matthewlai/GloveElectronics/Glove.pdf

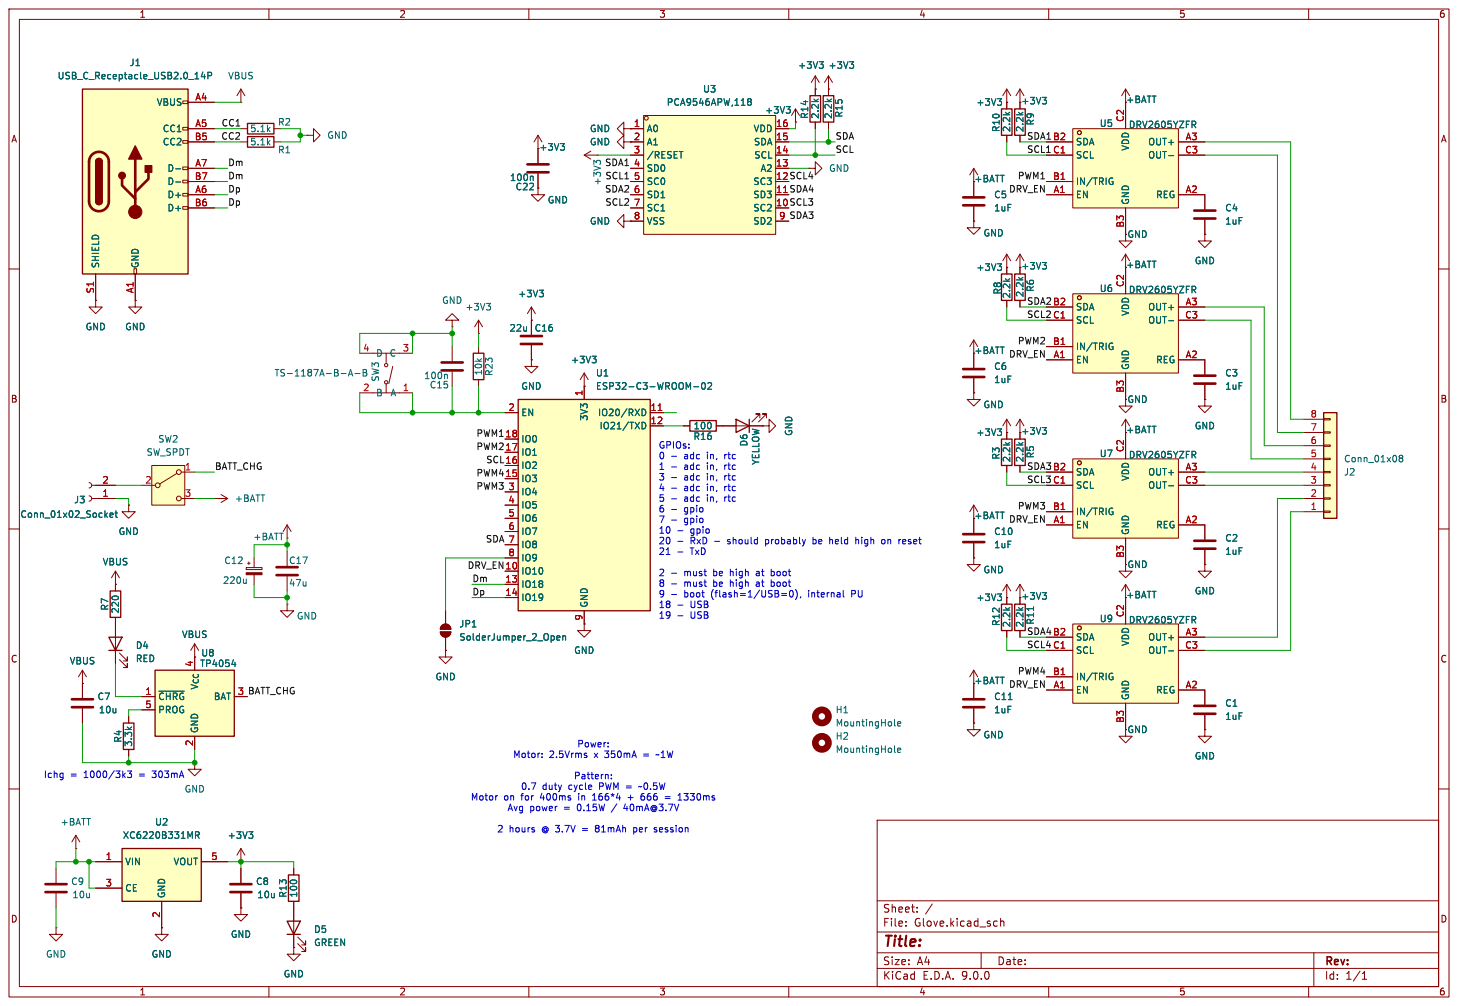
[picture p1: page 1]

Id: 1/1 Title: File: Glove.kicad_sch Sheet: / +3V3 A

Pattern: 0.7 duty cycle PWM = ~0.5W

Motor on for 400ms in 166*4 + 666 = 1330ms Avg power = 0.15W / 40mA@3.7V
