matthewlai/GloveElectronics/MotorConnectorBoard/MotorConnectorBoard.kicad_pcb

## KiCad design MotorConnectorBoard/MotorConnectorBoard.kicad_pcb (2026-07-17)

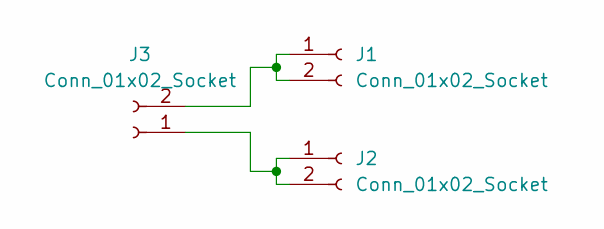
[picture p2: schematic MotorConnectorBoard.kicad_sch]

Parts:
J1, J2: Conn_01x02_Socket; PinHeader_1x02_P2.54mm_Vertical
J3: Conn_01x02_Socket; VLV101040A

Connections:
unnamed: J1.1, J1.2, J3.2
unnamed: J2.1, J2.2, J3.1

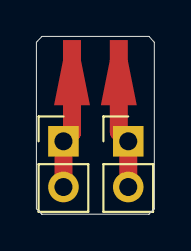
[picture p3: board MotorConnectorBoard.kicad_pcb from above]

Board: 2 copper layers, 6.6 x 9.9 mm, 3 parts (0 on the bottom side), 2 nets.
