matthewlai/GloveElectronics/Glove.kicad_pcb

## KiCad design Glove.kicad_pcb (2026-07-17)

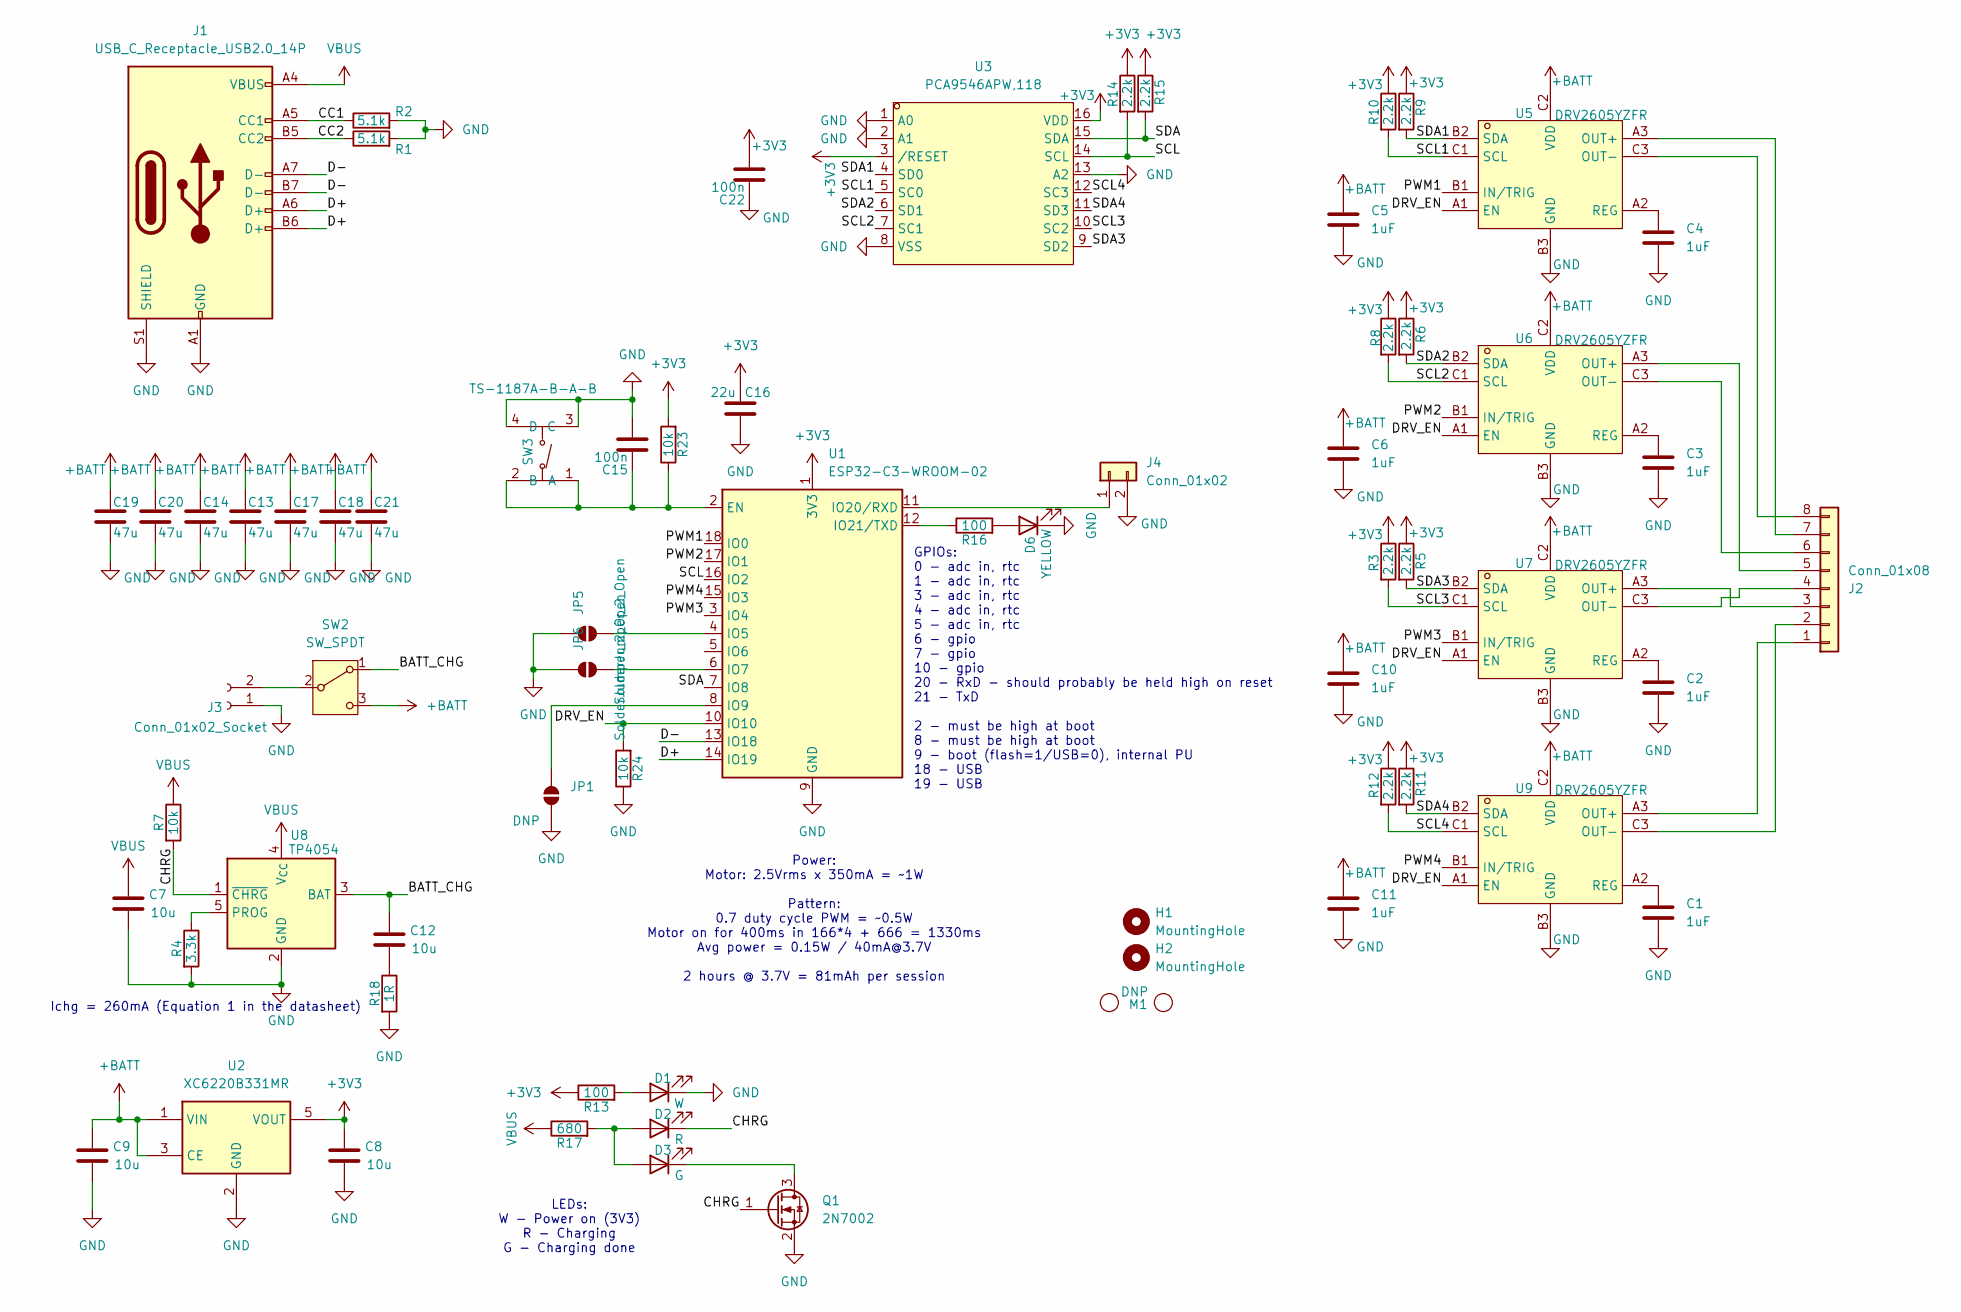
[picture p4: schematic Glove.kicad_sch]

Parts:
C1, C2, C3, C4, C5, C6, C10, C11: 1uF; C_0402_1005Metric; LCSC C52923
C7, C8, C9, C12: 10u; C_0603_1608Metric; LCSC C19702
C13, C14, C17, C18, C19, C20, C21: 47u; C_1206_3216Metric; LCSC C96123
C15, C22: 100n; C_0402_1005Metric; LCSC C1525
C16: 22u; C_0603_1608Metric; LCSC C59461
D1: W; LED_0603_1608Metric; LCSC C2290
D2: R; LED_0603_1608Metric; LCSC C2286
D3: G; LED_0603_1608Metric; LCSC C12624
D6: YELLOW; LED_0805_2012Metric; LCSC C2296
H1, H2: MountingHole; MountingHole_2.2mm_M2
J1: USB_C_Receptacle_USB2.0_14P; USB-C_SMD-TYPE-C-31-M-12; LCSC C165948
J2: Conn_01x08; PinHeader_2x04_P2.54mm_Vertical; LCSC C32713277
J3: Conn_01x02_Socket; CONN-SMD_B2B-PH-SM4-TB-LF-SN; LCSC C265003
J4: Conn_01x02; PinHeader_1x02_P2.54mm_Vertical
JP1: DNP; PinHeader_1x02_P2.54mm_Vertical
JP5, JP6: SolderJumper_2_Open; SolderJumper-2_P1.3mm_Open_RoundedPad1.0x1.5mm
M1: DNP; VLP2
Q1: 2N7002; SOT-323_SC-70; LCSC C7420322
R1, R2: 5.1k; R_0402_1005Metric; LCSC C25905
R3, R5, R6, R8, R9, R10, R11, R12, R14, R15: 2.2k; R_0402_1005Metric; LCSC C25879
R4: 3.3k; R_0402_1005Metric; LCSC C25890
R7, R23, R24: 10k; R_0402_1005Metric; LCSC C25744
R13, R16: 100; R_0402_1005Metric; LCSC C25076
R17: 680; R_0402_1005Metric; LCSC C25130
R18: 1R; R_0402_1005Metric; LCSC C25086
SW2: SW_SPDT; SW-TH_SK12D07VG3; LCSC C431547
SW3: TS-1187A-B-A-B; SW-SMD_4P-L5.1-W5.1-P3.70-LS6.5-TL_H1.5; LCSC Part C318884
U1: ESP32-C3-WROOM-02; LCSC C2934560
U2: XC6220B331MR; SOT-23-5; LCSC C86534
U3: PCA9546APW,118; SOP-16_L5.0-W4.4-P0.65-LS6.4-BL; LCSC Part C149507
U5, U6, U7, U9: DRV2605YZFR; DSBGA-9_L1.5-W1.5-R3-C3-P0.50-BL; LCSC Part C81079
U8: TP4054; SOT-23-5; LCSC C32574

Connections:
+3V3: C8.1, C16.1, C22.2, R3.1, R5.1, R6.1, R8.1, R9.1, R10.1, R11.1, R12.1, R13.1, R14.1, R15.1, R23.2, U1.1 (3V3), U2.5 (VOUT), U3.3 (/RESET), U3.16 (VDD)
+BATT: C5.1, C6.1, C9.1, C10.1, C11.1, C13.1, C14.1, C17.1, C18.1, C19.1, C20.1, C21.1, SW2.3 (C), U2.1 (VIN), U2.3 (CE), U5.C2 (VDD), U6.C2 (VDD), U7.C2 (VDD), U9.C2 (VDD)
/BATT_CHG: C12.1, SW2.1 (A), U8.3 (BAT)
/CC1: J1.A5 (CC1), R2.1
/CC2: J1.B5 (CC2), R1.1
/CHRG: D2.1 (K), Q1.1 (G), R7.2, U8.1 (~CHRG)
/D+: J1.A6 (D+), J1.B6 (D+), U1.14 (IO19)
/D-: J1.A7 (D-), J1.B7 (D-), U1.13 (IO18)
/DRV_EN: R24.2, U1.10 (IO10), U5.A1 (EN), U6.A1 (EN), U7.A1 (EN), U9.A1 (EN)
/PWM1: U1.18 (IO0), U5.B1 (IN/TRIG)
/PWM2: U1.17 (IO1), U6.B1 (IN/TRIG)
/PWM3: U1.3 (IO4), U7.B1 (IN/TRIG)
/PWM4: U1.15 (IO3), U9.B1 (IN/TRIG)
/SCL: R14.2, U1.16 (IO2), U3.14 (SCL)
/SCL1: R10.2, U3.5 (SC0), U5.C1 (SCL)
/SCL2: R8.2, U3.7 (SC1), U6.C1 (SCL)
/SCL3: R3.2, U3.10 (SC2), U7.C1 (SCL)
/SCL4: R12.2, U3.12 (SC3), U9.C1 (SCL)
/SDA: R15.2, U1.7 (IO8), U3.15 (SDA)
/SDA1: R9.2, U3.4 (SD0), U5.B2 (SDA)
/SDA2: R6.2, U3.6 (SD1), U6.B2 (SDA)
/SDA3: R5.2, U3.9 (SD2), U7.B2 (SDA)
/SDA4: R11.2, U3.11 (SD3), U9.B2 (SDA)
GND: C1.2, C2.2, C3.2, C4.2, C5.2, C6.2, C7.2, C8.2, C9.2, C10.2, C11.2, C13.2, C14.2, C15.2, C16.2, C17.2, C18.2, C19.2, C20.2, C21.2, C22.1, D1.1 (K), D6.1 (K), J1.A1 (GND), J1.A12 (GND), J1.B1 (GND), J1.B12 (GND), J1.S1 (SHIELD), J3.1, J4.2, JP1.1 (A), JP5.2 (B), JP6.2 (B), Q1.2 (S), R1.2, R2.2, R4.2, R18.2, R24.1, SW3.3 (C), SW3.4 (D), U1.9 (GND), U1.19 (GND), U2.2 (GND), U3.1 (A0), U3.2 (A1), U3.8 (VSS), U3.13 (A2), U5.B3 (GND), U6.B3 (GND), U7.B3 (GND), U8.2 (GND), U9.B3 (GND)
unnamed: C12.2, R18.1
unnamed: D1.2 (A), R13.2
unnamed: D2.2 (A), D3.2 (A), R17.2
unnamed: D3.1 (K), Q1.3 (D)
unnamed: D6.2 (A), R16.2
unnamed: J2.1, U9.A3 (OUT+)
unnamed: J2.2, U9.C3 (OUT-)
unnamed: J2.3, U7.A3 (OUT+)
unnamed: J2.4, U7.C3 (OUT-)
unnamed: J2.5, U6.A3 (OUT+)
unnamed: J2.6, U6.C3 (OUT-)
unnamed: J2.7, U5.A3 (OUT+)
unnamed: J2.8, U5.C3 (OUT-)
unnamed: J3.2, SW2.2 (B)
unnamed: J4.1, U1.11 (IO20/RXD)
unnamed: JP1.2 (B), U1.8 (IO9)
unnamed: JP5.1 (A), U1.4 (IO5)
unnamed: JP6.1 (A), U1.6 (IO7)
unnamed: C15.1, R23.1, SW3.1 (A), SW3.2 (B), U1.2 (EN)
unnamed: R16.1, U1.12 (IO21/TXD)
unnamed: C4.1, U5.A2 (REG)
unnamed: C3.1, U6.A2 (REG)
unnamed: C2.1, U7.A2 (REG)
unnamed: R4.1, U8.5 (PROG)
unnamed: C1.1, U9.A2 (REG)
VBUS: C7.1, J1.A4 (VBUS), J1.A9 (VBUS), J1.B4 (VBUS), J1.B9 (VBUS), R7.1, R17.1, U8.4 (V_{CC})

Notes on the sheet:
LEDs: W - Power on (3V3) R - Charging G - Charging done
GPIOs: 0 - adc in, rtc 1 - adc in, rtc 3 - adc in, rtc 4 - adc in, rtc 5 - adc in, rtc 6 - gpio 7 - gpio 10 - gpio 20 - RxD - should probably be held high on reset 21 - TxD 2 - must be high at boot 8 - must be high at boot 9 - boot (flash=1/USB=0), internal PU 18 - USB 19 - USB
Power: Motor: 2.5Vrms x 350mA = ~1W Pattern: 0.7 duty cycle PWM = ~0.5W Motor on for 400ms in 166*4 + 666 = 1330ms Avg power = 0.15W / 40mA@3.7V 2 hours @ 3.7V = 81mAh per session
Ichg = 260mA (Equation 1 in the datasheet)

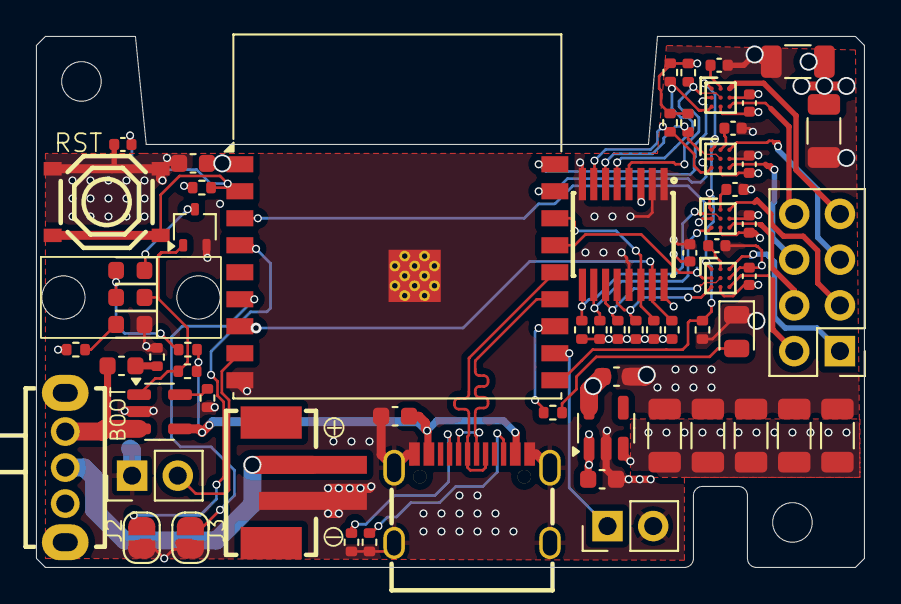
[picture p5: board Glove.kicad_pcb from above]

Board: 4 copper layers, 46.0 x 29.5 mm, 67 parts (0 on the bottom side), 50 nets.
