matthewlai/GloveElectronics/(commit log)

2025-05-25 Added button connector
    [Glove.kicad_pcb, Glove.kicad_sch]
2025-06-02 Update main.ino
    Refactored the loop into smaller bits. Still needs work, and to rely a lot less on Sleep() calls for timing.
    Also fixed Serial initialization, which was missing the baud rate.
    [main.ino]
2025-06-05 Fix immediate shutdown and lack of serial output
    * Fixed Serial initialization.
    * The battery low indication counter check was inverted.
    [main.ino]
2025-06-05 Pump up the power!
    Set the power to the motors to almost full. This is something that will ideally be configurable in the future.
2025-06-05 Readability improvements
    Group related functions , introduce a few constants, that kind of thing.
    Makes for a large change that doesn't do much in terms of code, unfortunately.
    [main.ino]
2025-06-09 Fix battery monitoring and memory leak
    Small improvements:
    Was reading the battery level only once.
    Was leaking memory on reconnect.
    [main.ino]
2026-07-17 PCB updates. Don't remember what they were...
